pichacker/Mondeo-MK4-DW12C-DPF-Monitor/Wiring.JPG

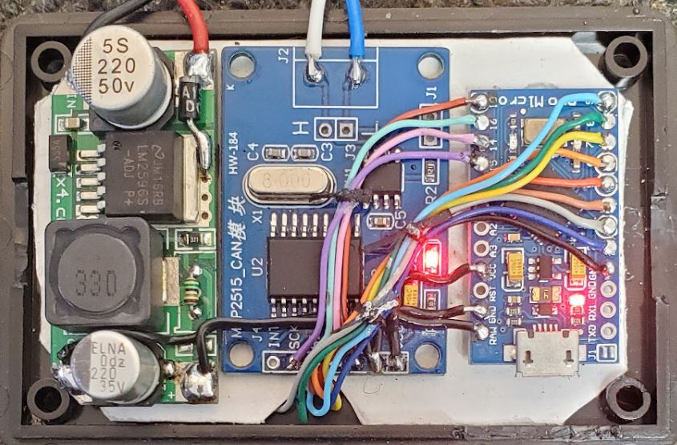
Wiring.JPG
