pichacker/Mondeo-MK4-DW12C-DPF-Monitor/Parts.JPG

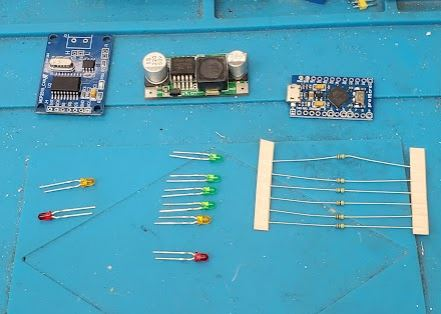
Parts.JPG
