pichacker/Mondeo-MK4-DW12C-DPF-Monitor/Boards.JPG

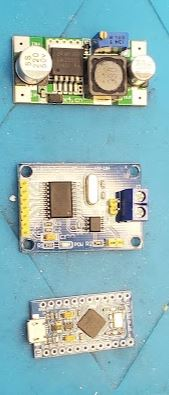
Boards.JPG
