pichacker/Mondeo-MK4-DW12C-DPF-Monitor/Front.JPG

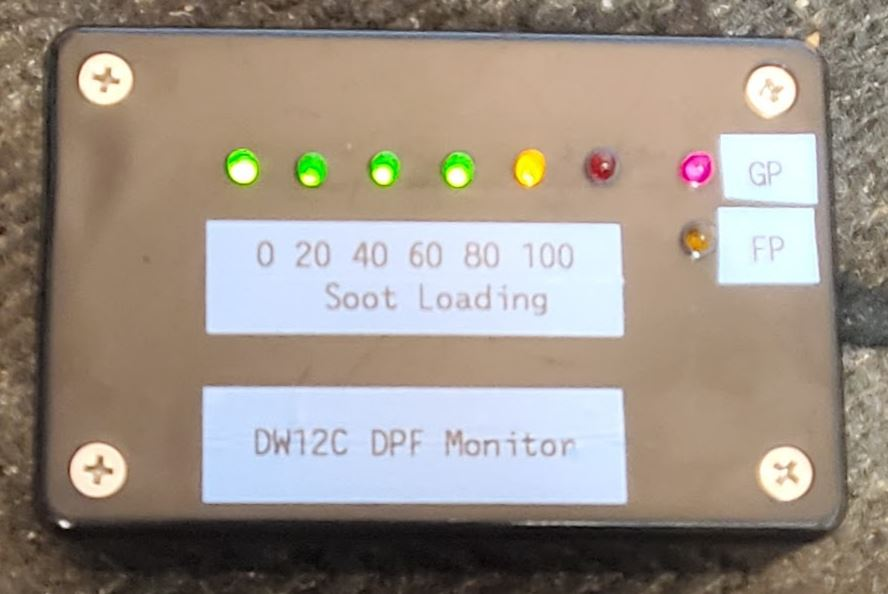
Front.JPG
