pichacker/Mondeo-MK4-DW12C-DPF-Monitor/LEDs.JPG

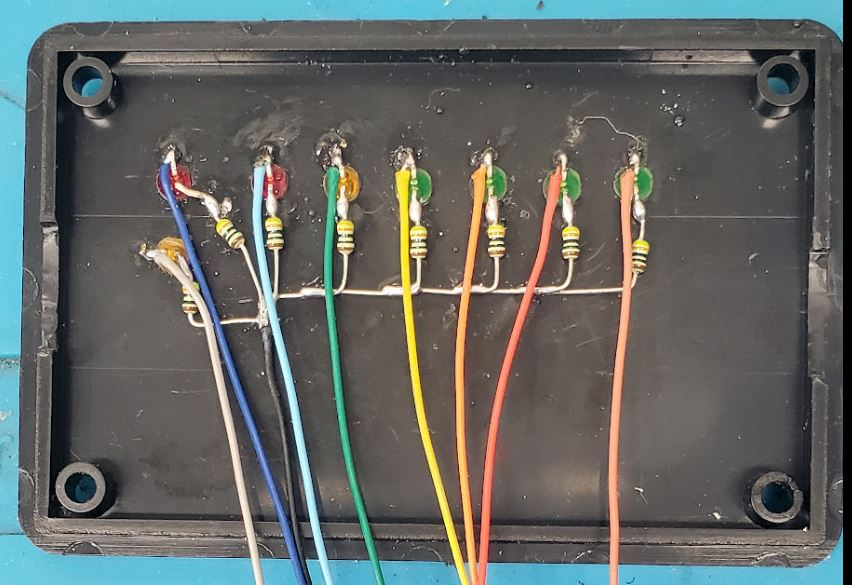
LEDs.JPG
